BMED-2310-AlphaX/Prototype-Generation-1/alphax_tvns_ble/2x5 cm compact - ORDERED VERSION/render_top.png

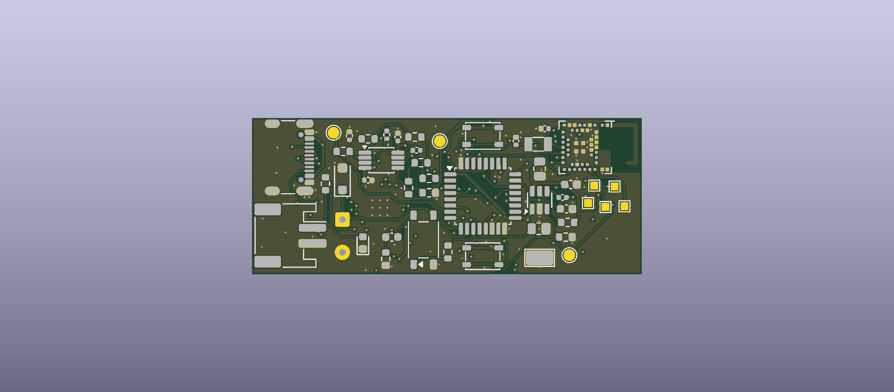
alphax_tvns_ble/2x5 cm compact - ORDERED VERSION/render_top.png
