BMED-2310-AlphaX/Prototype-Generation-1/alphax_tvns_ble/2x5 cm compact/render_bottom.png

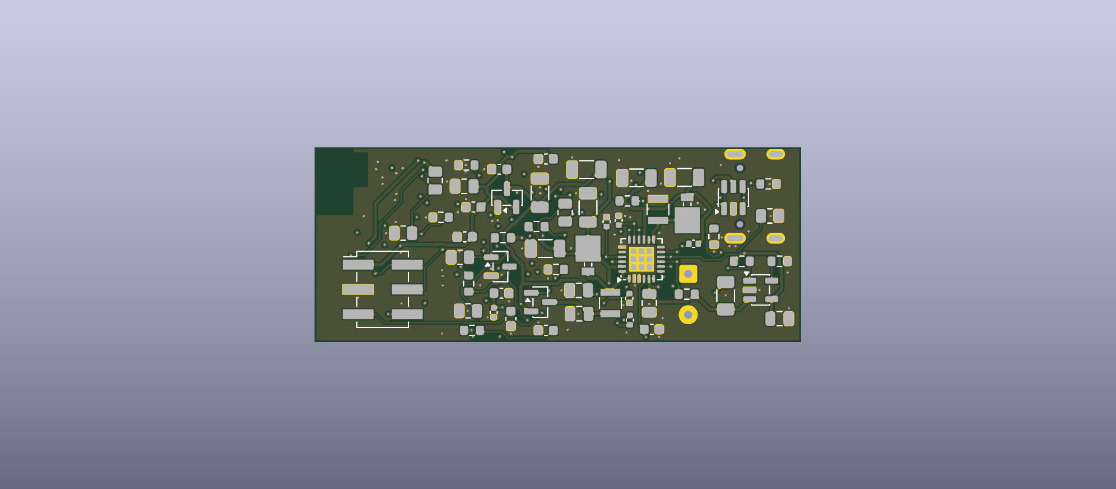
alphax_tvns_ble/2x5 cm compact/render_bottom.png
