BMED-2310-AlphaX/Prototype-Generation-1/alphax_tvns_ble/2x5 cm compact - ORDERED VERSION/DRC_report.txt

** Drc report for STM32G431kbt6_2x5_compact.kicad_pcb **
** Created on 2026-11-11T04:06:39 **
** Report includes: Errors **

** Found 0 DRC violations **

** Found 0 unconnected pads **

** Found 0 Footprint errors **

** Ignored checks **
    - Footprint has no courtyard defined
    - Track endpoint not centered on via
    - Tuning profile track geometries
    - Footprint doesn't match symbol's footprint filters
    - Footprint component type doesn't match footprint pads

** End of Report **
