BMED-2310-AlphaX/Prototype-Generation-1/alphax_tvns_ble/oscilloscope captures/middle rail to C_block output.png

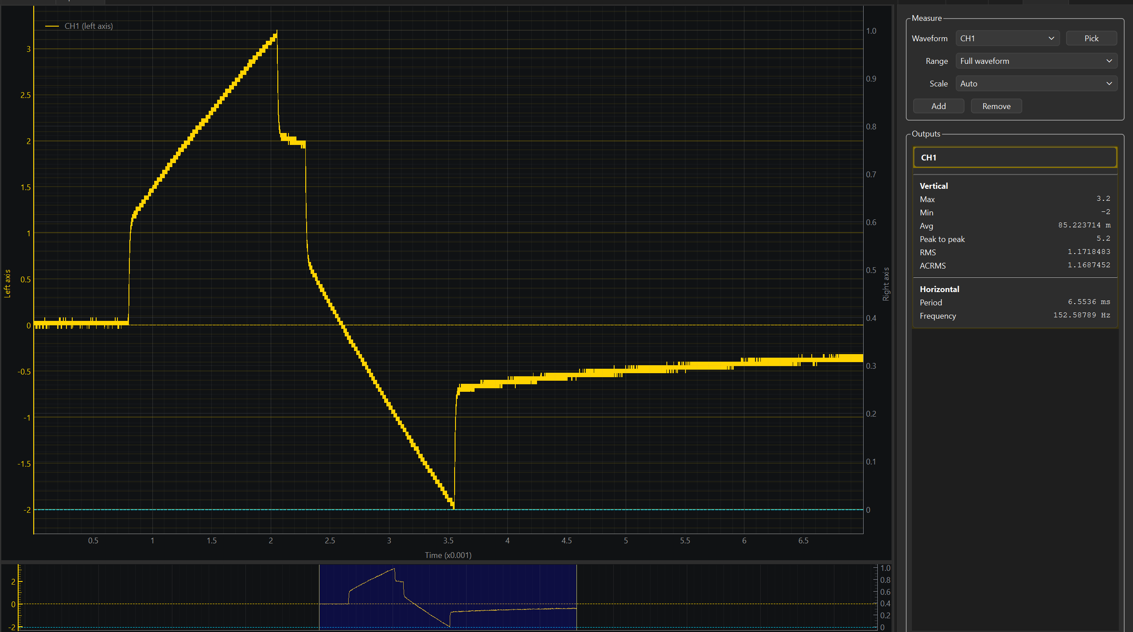
alphax_tvns_ble/oscilloscope captures/middle rail to C_block output.png
