BMED-2310-AlphaX/Prototype-Generation-1/alphax_tvns_ble/oscilloscope captures/TEK_rbody_scaling.png

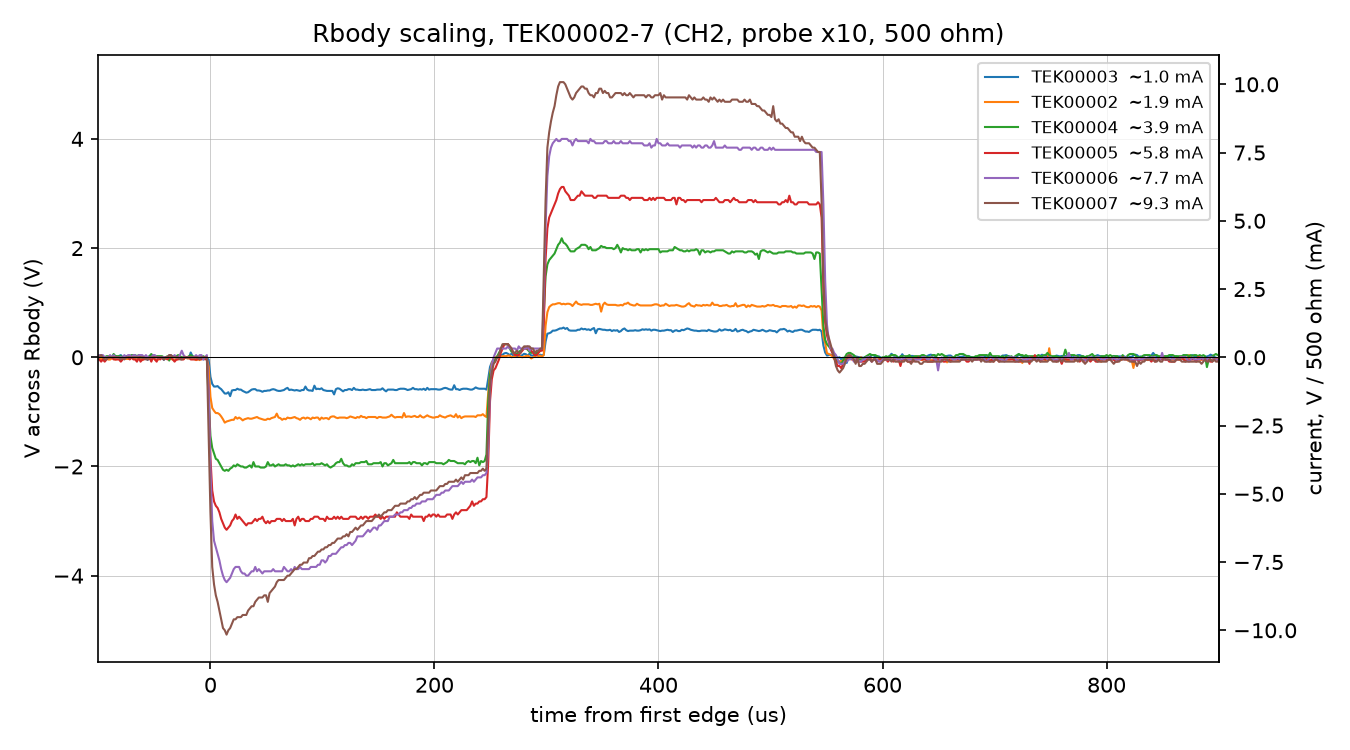
alphax_tvns_ble/oscilloscope captures/TEK_rbody_scaling.png
