BMED-2310-AlphaX/Prototype-Generation-1/alphax_tvns_ble/Screenshot 2026-11-03 141128.png

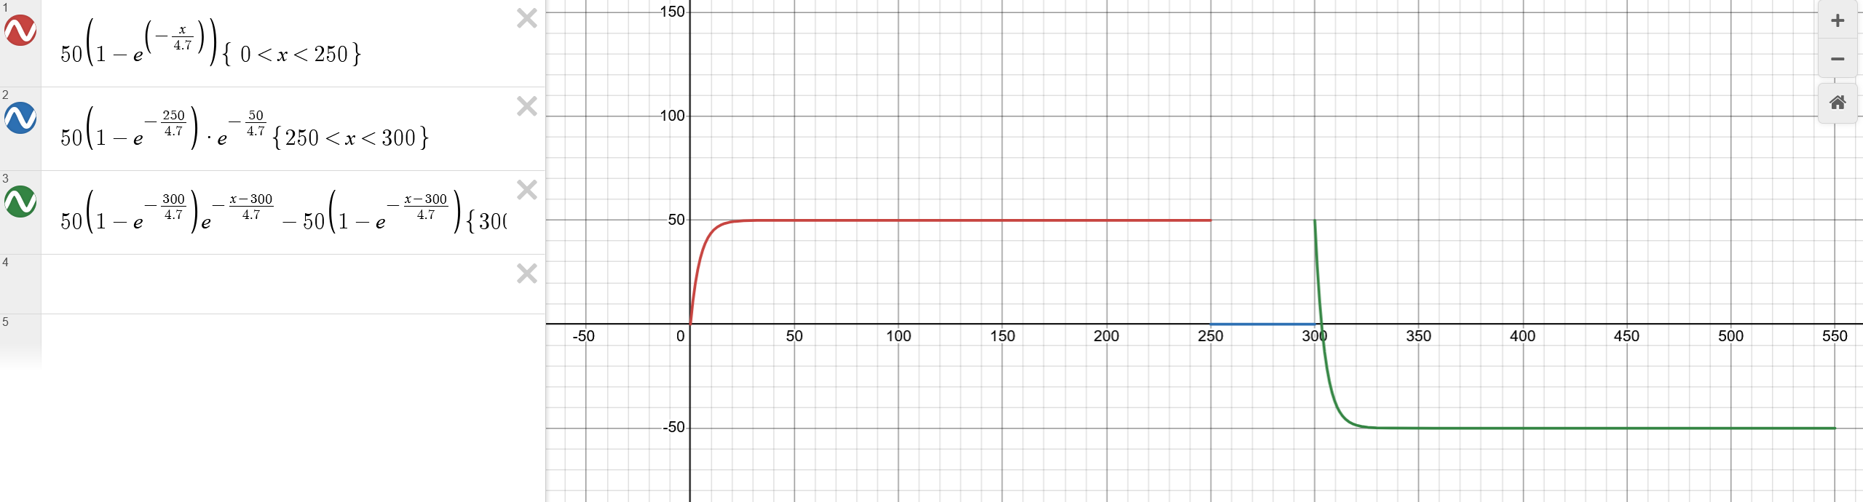
alphax_tvns_ble/Screenshot 2026-11-03 141128.png
