BMED-2310-AlphaX/Prototype-Generation-1/alphax_tvns_ble/2x5 cm compact - ORDERED VERSION/STM32G431kbt6_2x5_compact_colored.step

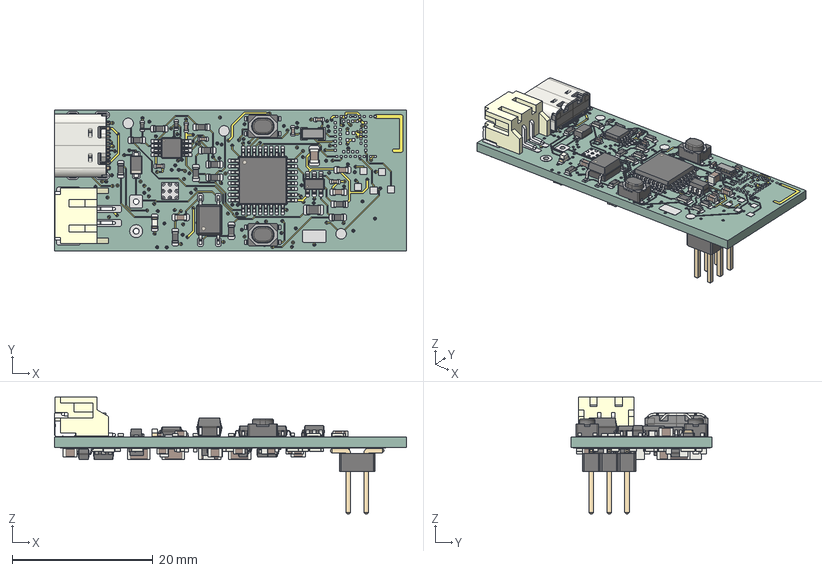
[picture p8: CAD file, 2026-11-11]
alphax_tvns_ble/2x5 cm compact - ORDERED VERSION/STM32G431kbt6_2x5_compact_colored.step
50.0 x 20.0 x 16.6 mm
D_SOD_123F
C_0402_1005Metric_1 x 12
R_0603_1608Metric_1 x 25
C_0603_1608Metric_1 x 11
USB_C_Receptacle_16P_TopMnt_Horizontal_GCT_USB4105-xx-A
Crystal_SMD_3215-2Pin_3.2x1.5mm_1
SOT-23-6_1 x 2
VSSOP-8_3x3mm_P0.65mm_1
R_0402_1005Metric_1 x 2
R_0805_2012Metric_1 x 7
C_0805_2012Metric_1 x 6
SW_SPST_PTS810_1 x 2
LED_0603_1608Metric_1
LQFP-32_7x7mm_P0.8mm_1
Toshiba_SOIC-4-6_4.4x3.6mm_P1.27mm_1
Fuse_1206_3216Metric_1
PinHeader_2x03_P254mm_Vertical_SMD
SOT-23_1 x 3
C_1206_3216Metric_1 x 6
D_Powermite_AK x 2
SOT-23-5_1
STM1C45_copper
STM1C45_pad
STM1C45_via
STM1C45_PCB
S2B-PH-SM4-TB(LF)(SN)
