BMED-2310-AlphaX/Prototype-Generation-1/alphax_tvns_ble/2x5 cm compact/STM32G431kbt6_2x5_compact.step

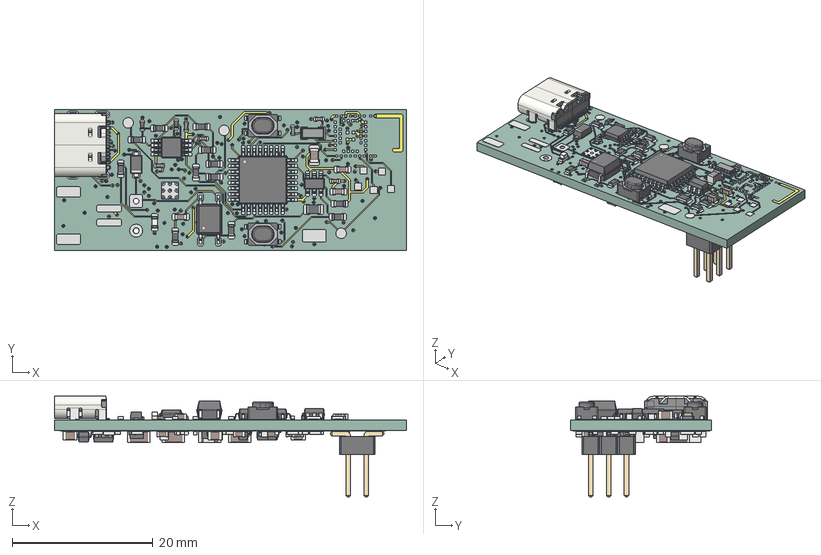
[picture p9: CAD file, 2026-11-11]
alphax_tvns_ble/2x5 cm compact/STM32G431kbt6_2x5_compact.step
50.0 x 20.0 x 14.3 mm
D_SOD_123F
C_0402_1005Metric x 12
R_0603_1608Metric x 25
C_0603_1608Metric x 11
USB_C_Receptacle_16P_TopMnt_Horizontal_GCT_USB4105-xx-A
Crystal_SMD_3215-2Pin_3.2x1.5mm
SOT-23-6 x 2
VSSOP-8_3x3mm_P0.65mm
R_0402_1005Metric x 2
R_0805_2012Metric x 7
C_0805_2012Metric x 6
SW_SPST_PTS810 x 2
LED_0603_1608Metric
LQFP-32_7x7mm_P0.8mm
Toshiba_SOIC-4-6_4.4x3.6mm_P1.27mm
Fuse_1206_3216Metric
PinHeader_2x03_P254mm_Vertical_SMD
SOT-23 x 3
C_1206_3216Metric x 6
D_Powermite_AK x 2
SOT-23-5
STM1C45_copper
STM1C45_pad
STM1C45_via
STM1C45_PCB
