BMED-2310-AlphaX/Prototype-Generation-1/Circuit layout/tvns_stim.asc

Cblock: cap; 2.2µ
Ci: cap; 1µ
Cskin1: cap; {Cskin}
Cskin2: cap; {Cskin}
D1: diode; 1N4148
D2: diode; 1N4148
R1: res; {Rset}
R2: res; {Rset+Rsense}
R3: res; {Rset}
R4: res; {Rset}
Rbleed: res; 100k
Rbody: res; {Rtis}
Ri: res; 1Meg
Rinj2: res; 10Meg
Rinj: res; 10Meg
Rp: res; 1Meg
Rs: res; {Rsense}
Rskin1: res; {Rskin}
Rskin2: res; {Rskin}
U1: UniversalOpAmp2; Avol=100k GBW=10Meg Slew=9Meg; Ilimit=38m Rail=1 Vos=0.5m
U2: UniversalOpAmp2; Avol=100k GBW=10Meg Slew=9Meg; Ilimit=38m Rail=1 Vos=0.5m
V1: voltage; PULSE(0 {Vset} 1m 1u 1u {PW} {1/Freq})
V2: voltage; PULSE(0 {-Vset} {1m+PW+IPG} 1u 1u {PW} {1/Freq})
Vneg: voltage; {-Vrail}
Vpos: voltage; {Vrail}
Named nets: vin, 0, +V, -V, drv, e1, out, inn, inp, sn, sp, vs
Electrode 1 (stim)
Electrode 2 (return) + neck tissue model
Improved Howland current pump (NE5532 half A): Iout = Vin*(1/Rsense + 1/Rset). R2 is trimmed to balance on the bench.
--- Tunable stimulation parameters ---
.param Iamp=2m Freq=25 PW=250u IPG=50u
.param Vrail=9 Rsense=100 Rset=150k
.param Vset={Iamp/(1/Rsense+1/Rset)}
.param Rskin=10k Cskin=470n Rtis=500
.tran 0 {1m+5/Freq} 0 1u
.step param Iamp list 2m 4m 10m 14m
.meas TRAN Ipos MAX I(Rbody)
.meas TRAN Ineg MIN I(Rbody)
.meas TRAN Vmax MAX V(drv)
.meas TRAN Vmin MIN V(drv)
.meas TRAN Qnet INTEG I(Rbody)
DC servo (NE5532 half B): holds the average of V(drv) at 0 V. D1/D2 clamp its inputs so it cannot latch at a rail.
.step param Vrail list 9 18
Vin = GPIO25 - GPIO26 on the bench. Firmware gain calibrated with "gain 29000".
.meas TRAN Voutmax MAX V(out)
.meas TRAN Voutmin MIN V(out)
.meas TRAN I1end FIND I(Rbody) AT={1m+PW-5u}
.meas TRAN Vservo FIND V(vs) AT=1m
