BMED-2310-AlphaX/Prototype-Generation-1/alphax_tvns_ble/wired schematics/STM32G431kbt6_wired.kicad_pcb

## KiCad design alphax_tvns_ble/wired schematics/STM32G431kbt6_wired.kicad_pcb (2026-11-11)

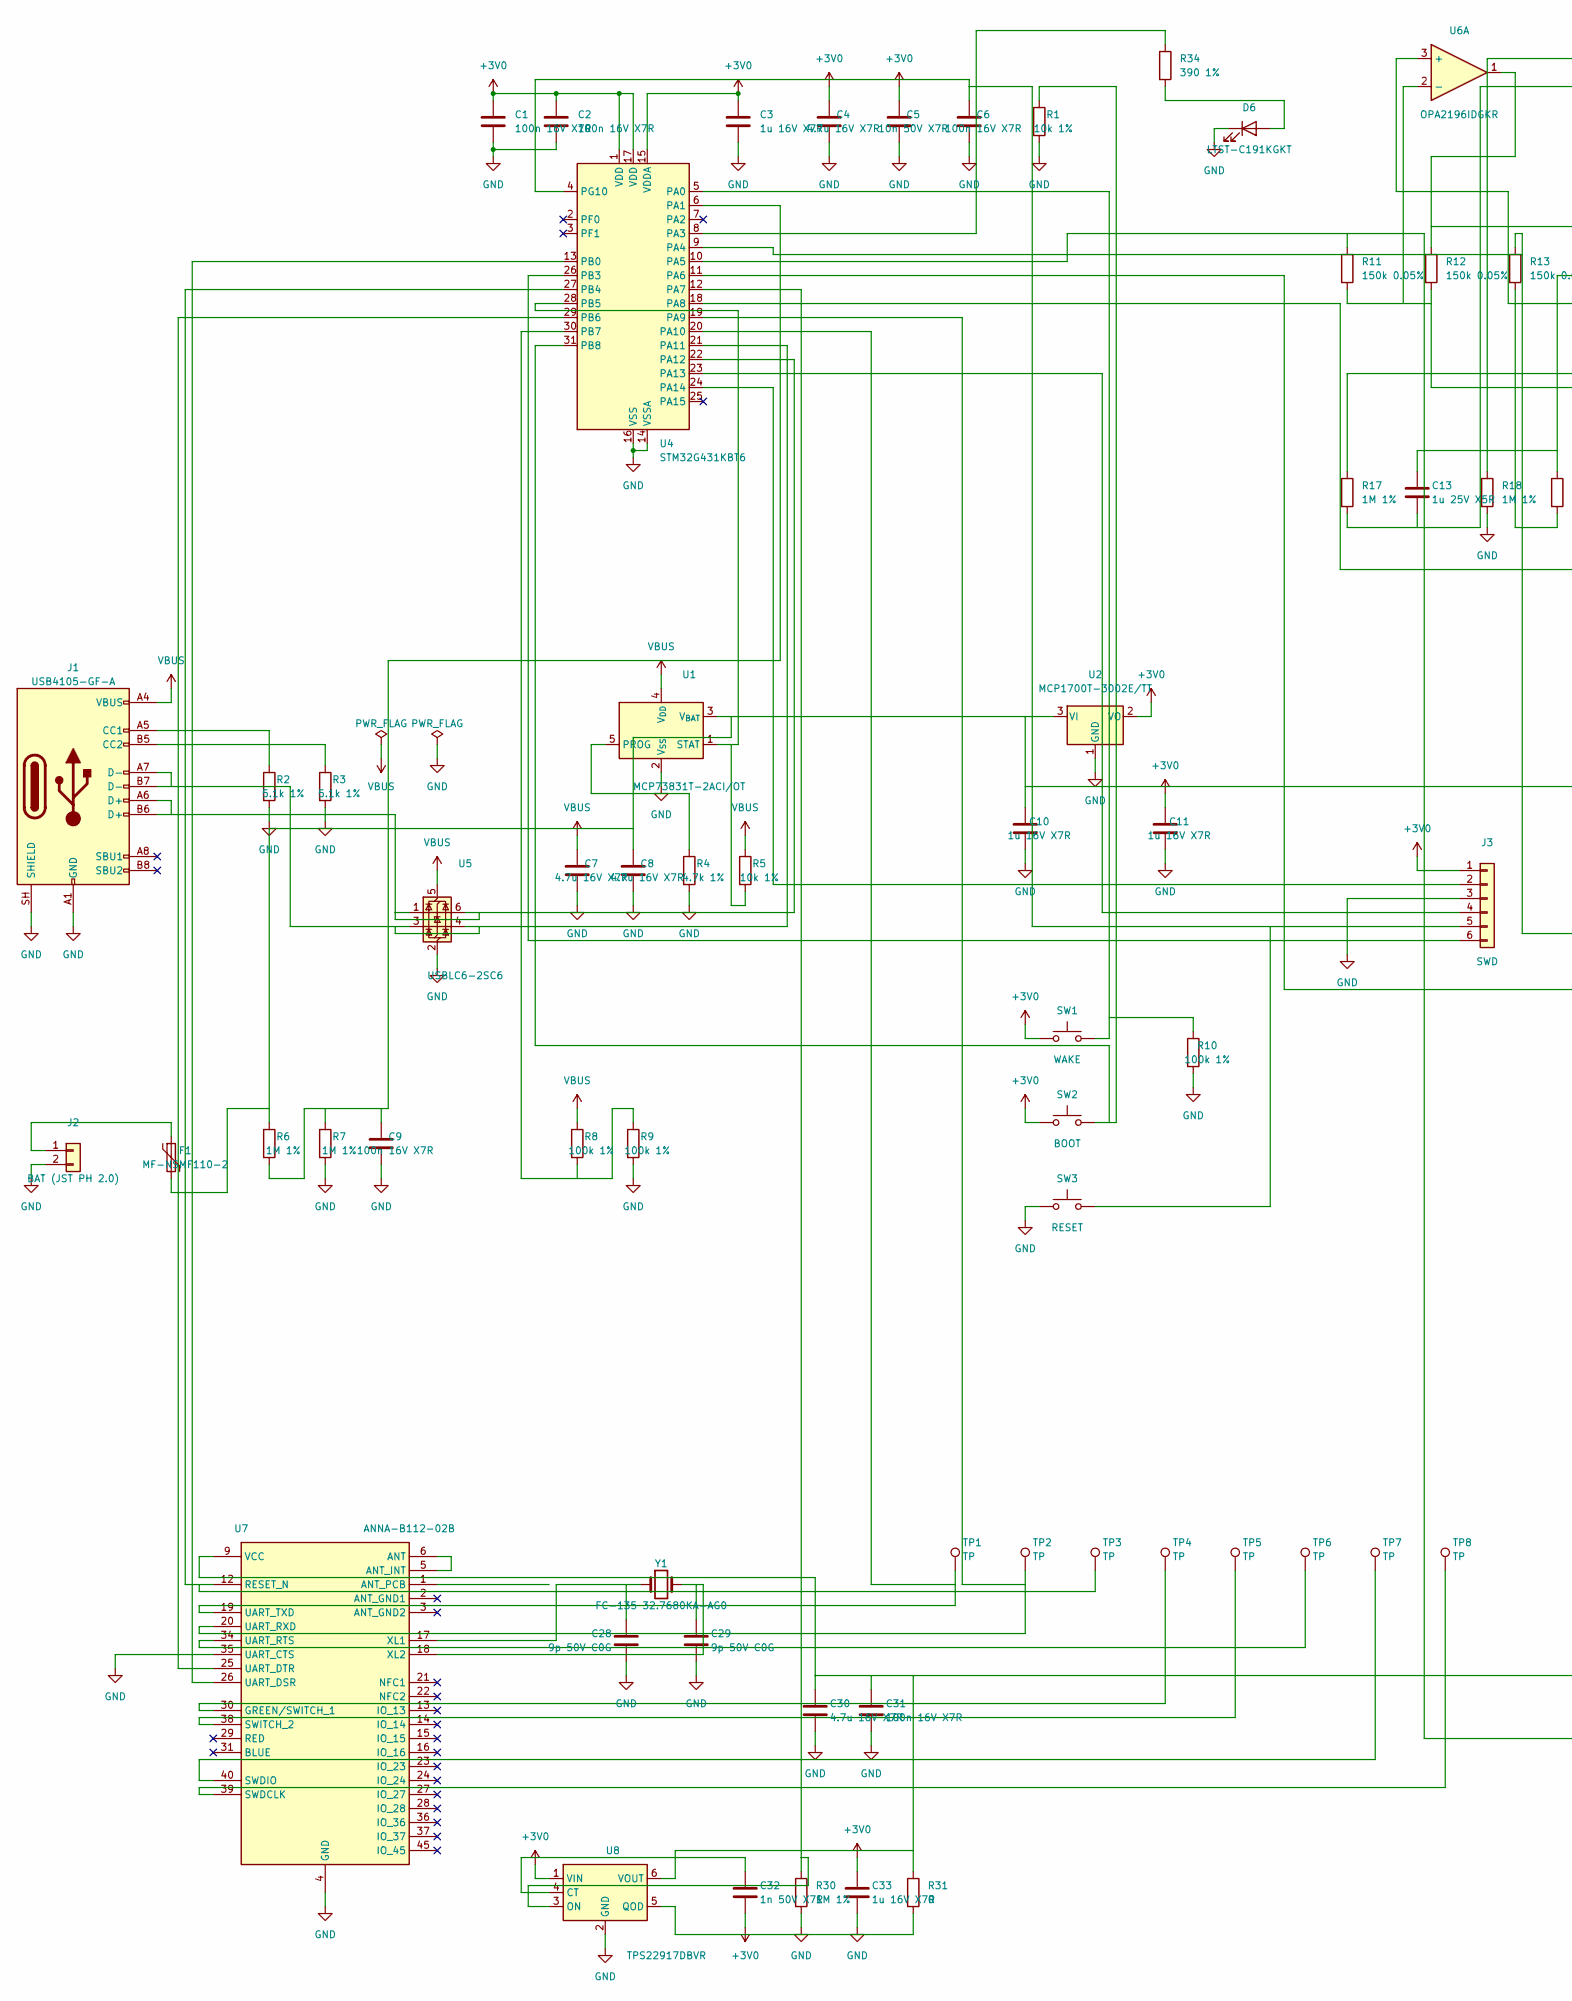
[picture p10: schematic STM32G431kbt6_wired.kicad_sch, part in row 1, column 1]

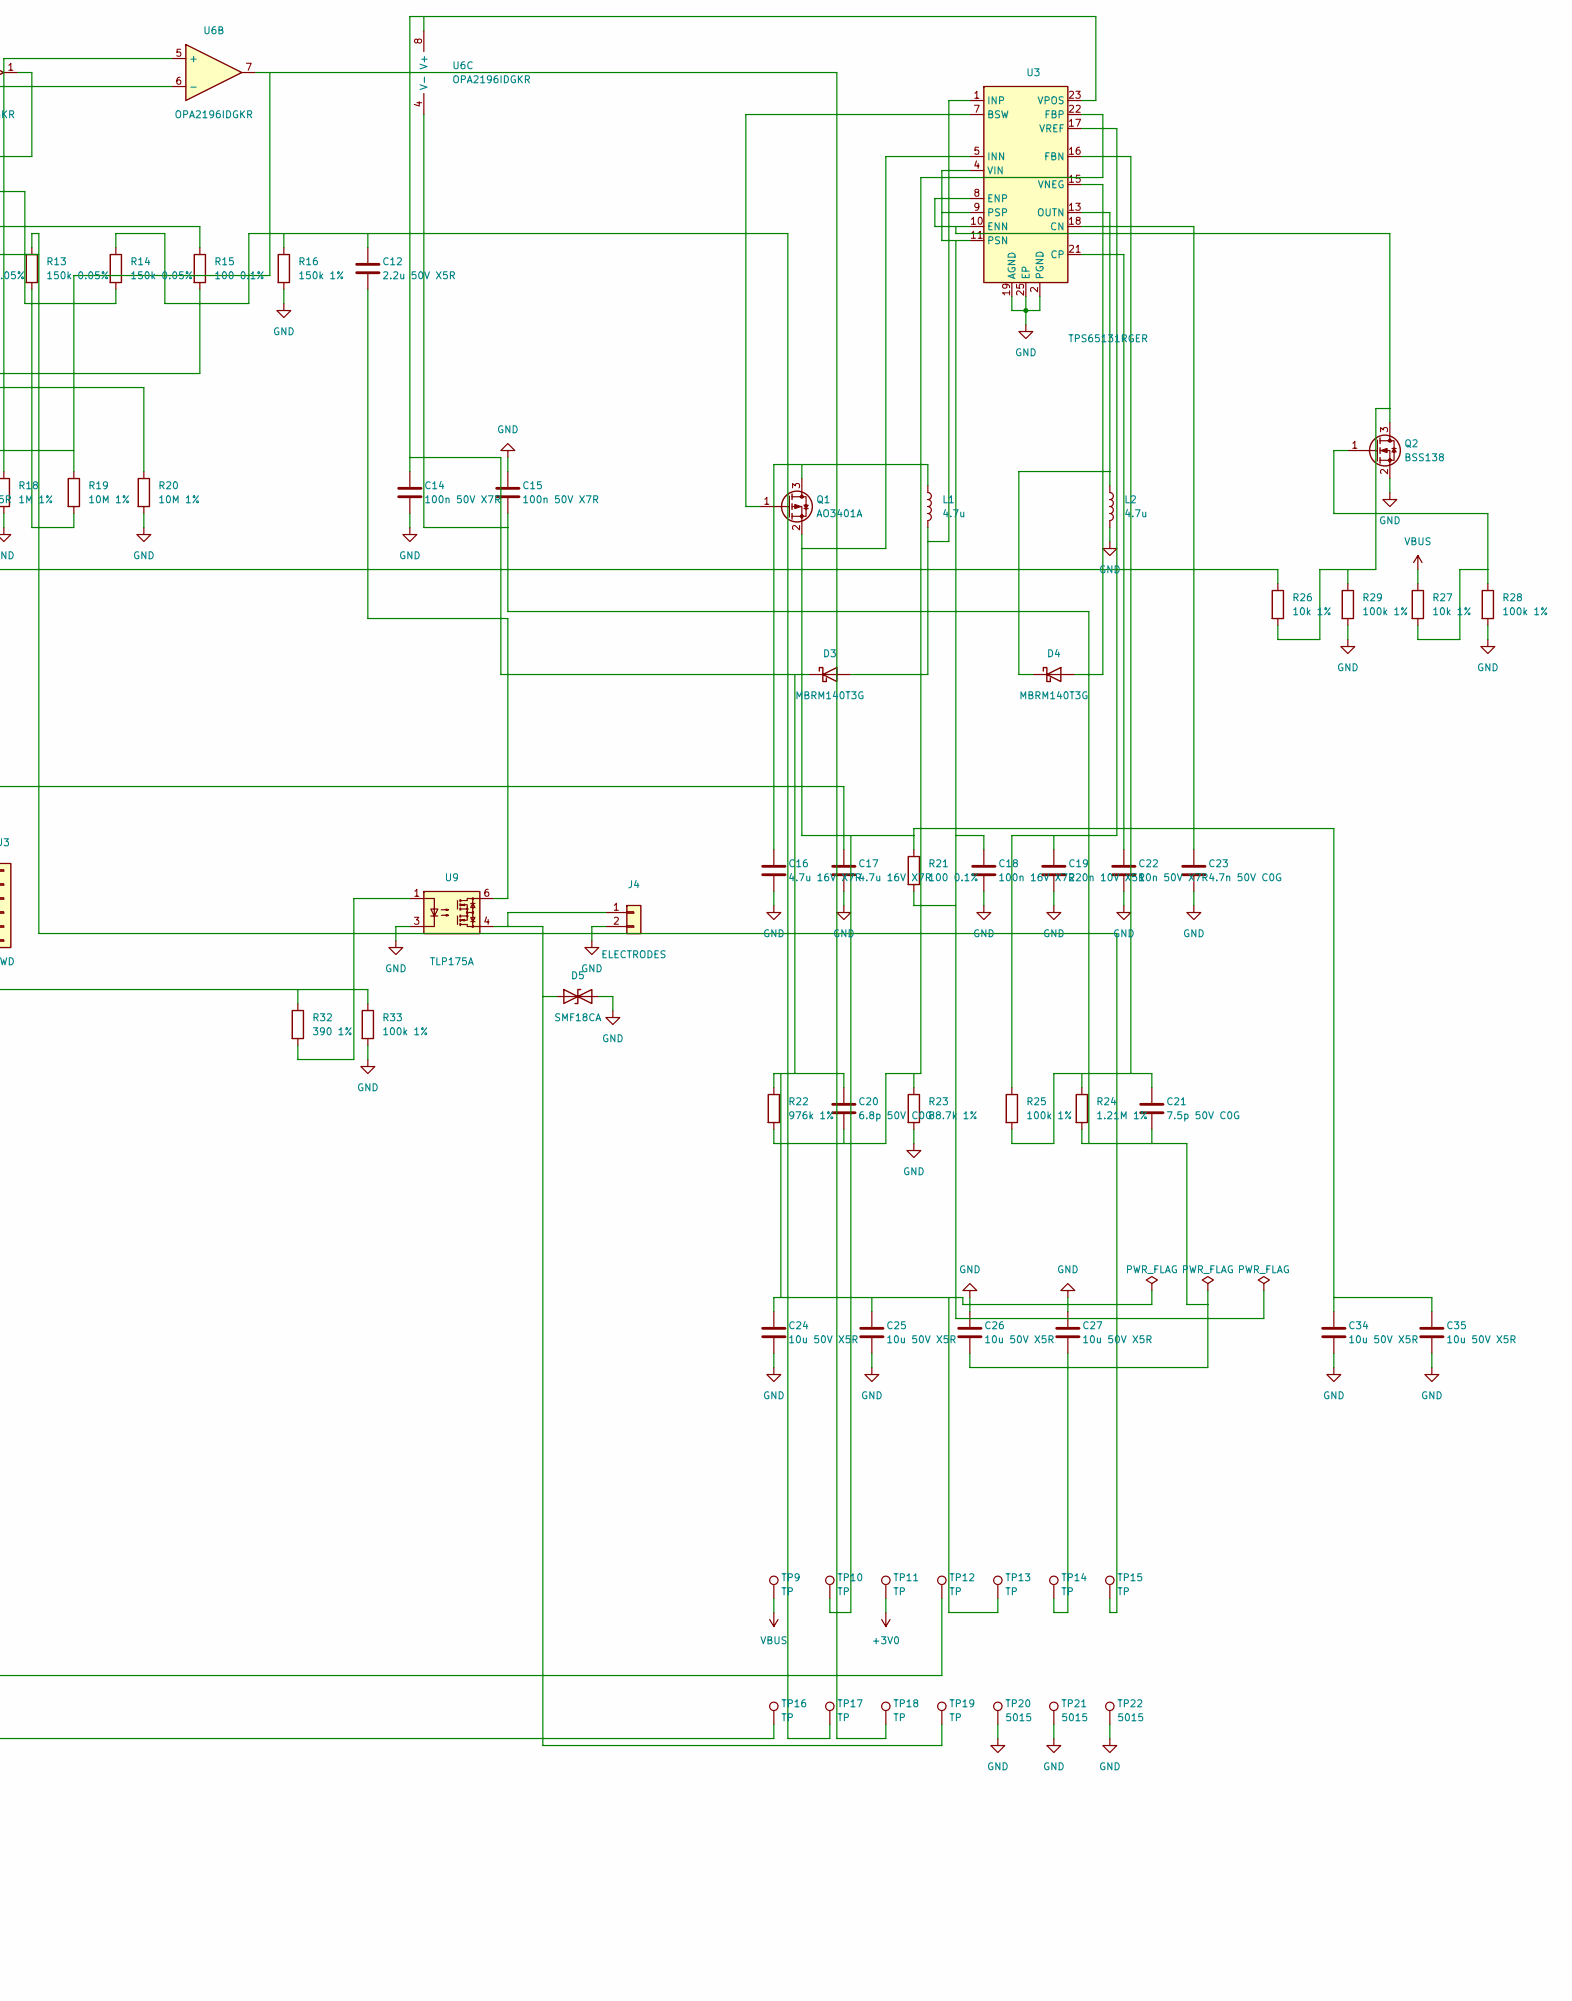
[picture p11: schematic STM32G431kbt6_wired.kicad_sch, part in row 1, column 2]

Parts:
C1, C2, C6, C9, C18, C31: 100n 16V X7R; C_0603_1608Metric; MPN C0603C104M4RACTU
C3, C10, C11, C33: 1u 16V X7R; C_0603_1608Metric; MPN EMK107B7105KA-T
C4, C7, C8, C16, C17, C30: 4.7u 16V X7R; C_0805_2012Metric; MPN GRM21BR71C475KE51L
C5, C22: 10n 50V X7R; C_0402_1005Metric; MPN CL05B103KB5NNNC
C12: 2.2u 50V X5R; C_0603_1608Metric; MPN GRT188R61H225KE13D
C13: 1u 25V X5R; C_0402_1005Metric; MPN C0402B105K025T
C14, C15: 100n 50V X7R; C_0402_1005Metric; MPN GCM155R71H104KE02J
C19: 220n 10V X5R; C_0402_1005Metric; MPN GRM155R61A224KE19D
C20: 6.8p 50V C0G; C_0402_1005Metric; MPN KGM05ACG1H6R8CH
C21: 7.5p 50V C0G; C_0402_1005Metric; MPN CC0402CRNPO9BN7R5
C23: 4.7n 50V C0G; C_0402_1005Metric; MPN GRM1555C1H472JE01D
C24, C25, C26, C27, C34, C35: 10u 50V X5R; C_1206_3216Metric; MPN UMK316BBJ106ML-T
C28, C29: 9p 50V C0G; C_0402_1005Metric; MPN CC0402CRNPO9BN9R0
C32: 1n 50V X7R; C_0402_1005Metric; MPN C0402C102K5RACTU
D3, D4: MBRM140T3G; D_Powermite_LargeCathode; MPN MBRM140T3G; DigiKey MBRM140T3GOSCT-ND
D5: SMF18CA; D_SOD-123F; MPN SMF18CA
D6: LTST-C191KGKT; LED_0603_1608Metric; MPN LTST-C191KGKT; DigiKey 160-1446-1-ND
F1: MF-NSMF110-2; Fuse_1206_3216Metric; MPN MF-NSMF110-2
J1: USB4105-GF-A; USB_C_Receptacle_GCT_USB4105-xx-A_16P_TopMnt_Horizontal; MPN USB4105-GF-A
J2: BAT (JST PH 2.0); JST_PH_S2B-PH-SM4-TB_1x02-1MP_P2.00mm_Horizontal; MPN S2B-PH-SM4-TB(LF)(SN)
J3: SWD; PinHeader_2x03_P2.54mm_Vertical_SMD; MPN PHED-SS006G1ABONE-B300
J4: ELECTRODES; SolderWire-0.25sqmm_1x02_P4.2mm_D0.65mm_OD1.7mm_Relief
L1, L2: 4.7u; L_TDK_TFM252012; MPN TFM252012ALMA4R7MTAA
Q1: AO3401A; SOT-23; MPN AO3401A
Q2: BSS138; SOT-23; MPN BSS138; DigiKey BSS138CT-ND
R1, R5, R26, R27: 10k 1%; R_0603_1608Metric; MPN RNCP0603FTD10K0
R2, R3: 5.1k 1%; R_0603_1608Metric; MPN RT0603FRE075K1L
R4: 4.7k 1%; R_0603_1608Metric; MPN RT0603FRE074K7L
R6, R7, R17, R18, R30: 1M 1%; R_0603_1608Metric; MPN MCT06030C1004FPW00
R8, R9, R10, R25, R28, R29, R33: 100k 1%; R_0805_2012Metric; MPN RT0805FRD07100KL
R11, R12, R13, R14: 150k 0.05%; R_0603_1608Metric; MPN RG1608N-154-W-T1; DigiKey RG16N150KWCT-ND
R15, R21: 100 0.1%; R_0603_1608Metric; MPN RG1608P-101-B-T5; DigiKey RG16P100BCT-ND
R16: 150k 1%; R_0603_1608Metric; MPN ERJ-3EKF1503V
R19, R20: 10M 1%; R_0402_1005Metric; MPN RMCF0402FT10M0
R22: 976k 1%; R_0603_1608Metric; MPN CR0603-FX-9763ELF
R23: 88.7k 1%; R_0603_1608Metric; MPN CR0603-FX-8872ELF
R24: 1.21M 1%; R_0603_1608Metric; MPN RM06F1214CT
R31: 0; R_0603_1608Metric; MPN MCT0603MZ0000ZP500
R32, R34: 390 1%; R_0603_1608Metric; MPN RT0603FRE07390RL
SW1: WAKE; SW_SPST_PTS810; MPN PTS810 SJM 250 SMTR LFS
SW2: BOOT; SW_SPST_PTS810; MPN PTS810 SJM 250 SMTR LFS
SW3: RESET; SW_SPST_PTS810; MPN PTS810 SJM 250 SMTR LFS
TP1, TP2, TP3, TP4, TP5, TP6, TP7, TP8: TP; TestPoint_Pad_1.0x1.0mm
TP9, TP10, TP11, TP12, TP13, TP14, TP15, TP16, TP17, TP18, TP19: TP; TestPoint_Pad_D1.5mm
TP20, TP21, TP22: 5015; TestPoint_Keystone_5015_Micro_Mini; MPN 5015
U1: MCP73831T-2ACI/OT; SOT-23-5; MPN MCP73831T-2ACI/OT
U2: MCP1700T-3002E/TT; SOT-23; MPN MCP1700T-3002E/TT
U3: TPS65131RGER; VQFN-24-1EP_4x4mm_P0.5mm_EP2.45x2.45mm_ThermalVias; MPN TPS65131RGER
U4: STM32G431KBT6; LQFP-32_7x7mm_P0.8mm; MPN STM32G431KBT6
U5: USBLC6-2SC6; SOT-23-6; MPN USBLC6-2SC6
U6: OPA2196IDGKR; VSSOP-8_3x3mm_P0.65mm; MPN OPA2196IDGKR
U7: ANNA-B112-02B; u-blox_ANNA-B112; MPN ANNA-B112-02B
U8: TPS22917DBVR; SOT-23-6; MPN TPS22917DBVR
U9: TLP175A; Toshiba_SOIC-4-6_4.4x3.6mm_P1.27mm; MPN TLP175A(TPL,E
Y1: FC-135 32.7680KA-AG0; Crystal_SMD_3215-2Pin_3.2x1.5mm; MPN FC-135 32.7680KA-AG0; DigiKey 114-FC-13532.7680KA-AG0CT-ND

Connections:
+3V0: C1.1, C2.1, C3.1, C4.1, C5.1, C11.1, C32.2, C33.1, J3.1, SW1.1, SW2.1, TP11.1 (1_1), U2.2 (VO), U4.1 (VDD), U4.15 (VDDA), U4.17 (VDD), U8.1 (VIN)
GND: C1.2, C2.2, C3.2, C4.2, C5.2, C6.2, C7.2, C8.2, C9.2, C10.2, C11.2, C14.2, C15.1, C16.2, C17.2, C18.2, C19.2, C22.2, C23.2, C24.2, C25.2, C26.1, C27.1, C28.2, C29.2, C30.2, C31.2, C33.2, C34.2, C35.2, D5.2 (A2), D6.1 (K), J1.A1 (GND), J1.A12 (GND), J1.B1 (GND), J1.B12 (GND), J1.SH (SHIELD), J2.2, J3.3, J4.2, L2.2, Q2.2 (S), R1.2, R2.2, R3.2, R4.2, R7.2, R9.2, R10.2, R16.2, R18.2, R20.2, R23.2, R28.2, R29.2, R30.2, R33.2, SW3.1 (1_1), TP20.1 (1_1), TP21.1 (1_1), TP22.1 (1_1), U1.2 (V_{SS}), U2.1 (GND), U3.2 (PGND), U3.3 (PGND), U3.19 (AGND), U3.25 (EP), U4.14 (VSSA), U4.16 (VSS), U4.32 (VSS), U5.2 (GND), U7.4 (GND), U7.7 (GND), U7.8 (GND), U7.10 (GND), U7.11 (GND), U7.32 (GND), U7.33 (GND), U7.35 (UART_CTS), U7.41 (GND), U7.42 (GND), U7.43 (GND), U7.44 (GND), U7.46 (GND), U7.47 (GND), U7.48 (GND), U7.49 (GND), U7.50 (GND), U7.51 (GND), U7.52 (GND), U8.2 (GND), U9.3; also elsewhere on the board
unnamed: C12.1, R14.1, R15.2, R16.1, R17.1, TP17.1 (1_1)
unnamed: C12.2, U9.6
unnamed: C20.1, R22.1
unnamed: C21.1, R24.1, R25.2
unnamed: C21.2, C26.2, C27.2, R24.2, TP14.1 (1_1)
unnamed: C24.1, C25.1
unnamed: D3.2 (A), L1.2, U3.1 (INP), U3.24 (INP)
unnamed: C14.1, D3.1 (K), U3.23 (VPOS), U6.8 (V+)
unnamed: C15.2, D4.2 (A), U3.15 (VNEG), U6.4 (V-)
unnamed: D4.1 (K), L2.1, U3.13 (OUTN), U3.14 (OUTN)
unnamed: D5.1 (A1), J4.1, TP19.1 (1_1), U9.4
unnamed: D6.2 (A), R34.2
unnamed: F1.2, R6.1
unnamed: J1.A5 (CC1), R2.1
unnamed: J1.B5 (CC2), R3.1
unnamed: F1.1, J2.1
unnamed: J3.2, U4.24 (PA14)
unnamed: J3.4, U4.23 (PA13)
unnamed: C6.1, J3.5, U4.4 (PG10)
unnamed: J3.6, U4.26 (PB3)
unnamed: C16.1, L1.1, Q1.3 (D)
unnamed: Q1.1 (G), U3.7 (BSW)
unnamed: C17.1, C34.1, C35.1, Q1.2 (S), R21.1, U3.5 (INN), U3.6 (INN)
unnamed: Q2.3 (D), R26.2, R29.1, U3.8 (ENP), U3.10 (ENN)
unnamed: Q2.1 (G), R27.2, R28.1
unnamed: R11.2, R12.2, R20.1
unnamed: R12.1, U6.1
unnamed: R13.1, TP15.1 (1_1)
unnamed: R19.1, TP18.1 (1_1), U6.7
unnamed: R32.2, U9.1
unnamed: R4.1, U1.5 (PROG)
unnamed: R5.2, U1.1 (STAT), U4.28 (PB5)
unnamed: C8.1, U1.3 (V_{BAT}), U2.3 (VI)
unnamed: C23.1, U3.18 (CN)
unnamed: C22.1, U3.21 (CP)
unnamed: C20.2, R22.2, R23.1, U3.22 (FBP)
unnamed: U3.4 (VIN), U3.9 (PSP), U3.11 (PSN)
unnamed: C19.1, R25.1, U3.17 (VREF)
unnamed: SW1.2, U4.5 (PA0)
unnamed: C9.1, R6.2, R7.1, U4.6 (PA1)
unnamed: R34.1, U4.8 (PA3)
unnamed: R11.1, TP16.1 (1_1), U4.10 (PA5)
unnamed: R32.1, R33.1, U4.11 (PA6)
unnamed: R30.1, U4.12 (PA7), U8.3 (ON)
unnamed: R26.1, U4.18 (PA8)
unnamed: TP2.1 (1_1), U4.19 (PA9), U7.20 (UART_RXD)
unnamed: TP1.1 (1_1), U4.20 (PA10), U7.19 (UART_TXD)
unnamed: J1.A7 (D-), J1.B7 (D-), U4.21 (PA11), U5.3 (I/O2), U5.4 (I/O2)
unnamed: J1.A6 (D+), J1.B6 (D+), U4.22 (PA12), U5.1 (I/O1), U5.6 (I/O1)
unnamed: U4.13 (PB0), U7.26 (UART_DSR)
unnamed: TP3.1 (1_1), U4.27 (PB4), U7.12 (RESET_N)
unnamed: U4.29 (PB6), U7.25 (UART_DTR)
unnamed: R8.2, R9.1, U4.30 (PB7)
unnamed: R1.1, SW2.2, U4.31 (PB8)
unnamed: R13.2, R14.2, R19.2, U6.3 (+)
unnamed: R18.1, U6.5 (+)
unnamed: C13.2, R17.2, U6.6 (-)
unnamed: U7.5 (ANT_INT), U7.6 (ANT)
unnamed: TP4.1 (1_1), U7.30 (GREEN/SWITCH_1)
unnamed: TP8.1 (1_1), U7.39 (SWDCLK)
unnamed: TP7.1 (1_1), U7.40 (SWDIO)
unnamed: TP5.1 (1_1), U7.38 (SWITCH_2)
unnamed: TP6.1 (1_1), U7.34 (UART_RTS)
unnamed: C30.1, C31.1, TP12.1 (1_1), U7.9 (VCC)
unnamed: C28.1, U7.17 (XL1), Y1.1
unnamed: C29.1, U7.18 (XL2), Y1.2
unnamed: C32.1, U8.4 (CT)
unnamed: R31.2, U8.5 (QOD)
VBUS: C7.1, J1.A4 (VBUS), J1.A9 (VBUS), J1.B4 (VBUS), J1.B9 (VBUS), R5.1, R8.1, R27.1, TP9.1 (1_1), U1.4 (V_{DD}), U5.5 (VBUS)

Board: 4 copper layers, 118 parts (0 on the bottom side), 71 nets, no tracks yet.

Other parts of the board:
NT1: NetTie_2; NetTie-2_SMD_Pad0.5mm

Their connections:
GND: NT1.2; also elsewhere on the board
