BMED-2310-AlphaX/Prototype-Generation-1/alphax_tvns_ble/STM32G431kbt6/Core/Inc/main.h

#define WAKE_Pin GPIO_PIN_0
#define WAKE_GPIO_Port GPIOA
#define WAKE_EXTI_IRQn EXTI0_IRQn
#define VBAT_SENSE_Pin GPIO_PIN_1
#define VBAT_SENSE_GPIO_Port GPIOA
#define STATUS_LED_Pin GPIO_PIN_3
#define STATUS_LED_GPIO_Port GPIOA
#define DAC_STIM_Pin GPIO_PIN_4
#define DAC_STIM_GPIO_Port GPIOA
#define DAC_REF_Pin GPIO_PIN_5
#define DAC_REF_GPIO_Port GPIOA
#define OUT_EN_Pin GPIO_PIN_6
#define OUT_EN_GPIO_Port GPIOA
#define BLE_EN_Pin GPIO_PIN_7
#define BLE_EN_GPIO_Port GPIOA
#define BLE_DSR_Pin GPIO_PIN_0
#define BLE_DSR_GPIO_Port GPIOB
#define EN_RAIL_MCU_Pin GPIO_PIN_8
#define EN_RAIL_MCU_GPIO_Port GPIOA
#define BLE_RXD_Pin GPIO_PIN_9
#define BLE_RXD_GPIO_Port GPIOA
#define BLE_TXD_Pin GPIO_PIN_10
#define BLE_TXD_GPIO_Port GPIOA
#define USB_DM_Pin GPIO_PIN_11
#define USB_DM_GPIO_Port GPIOA
#define USB_DP_Pin GPIO_PIN_12
#define USB_DP_GPIO_Port GPIOA
#define SWDIO_Pin GPIO_PIN_13
#define SWDIO_GPIO_Port GPIOA
#define SWCLK_Pin GPIO_PIN_14
#define SWCLK_GPIO_Port GPIOA
#define SWO_Pin GPIO_PIN_3
#define SWO_GPIO_Port GPIOB
#define BLE_RESET_N_Pin GPIO_PIN_4
#define BLE_RESET_N_GPIO_Port GPIOB
#define STAT_Pin GPIO_PIN_5
#define STAT_GPIO_Port GPIOB
#define BLE_DTR_Pin GPIO_PIN_6
#define BLE_DTR_GPIO_Port GPIOB
#define VBUS_SENSE_Pin GPIO_PIN_7
#define VBUS_SENSE_GPIO_Port GPIOB
#define VBUS_SENSE_EXTI_IRQn EXTI9_5_IRQn
