BMED-2310-AlphaX/Prototype-Generation-1/(commit log)

2026-10-27 Add circuit layout, ESP32 draft stim, STM32 stim
2026-10-29 adding app/esp32 code
    blah
2026-11-05 Add oscilloscope test files for CES and prototype.
2026-11-06 New analyses of the updated DC servo additions to the stimulating circuit
2026-11-08 added KiCad files for stm32g431kbt6. reorganized oscilloscope files
2026-11-08 Added battery management, USB programming functionality, and bootloading
2026-11-10 Added parts list for full chip parts and validated circuits.
2026-11-10 Fixed BOM issues.
2026-11-10 New manual schematics.
2026-11-11 Zipped gerber files for PCB ordering
2026-11-11 Added STEP file for the colored PCB, including SMD and connectors.
