BMED-2310-AlphaX/Prototype-Generation-1/(notices)

Notices in the files:
alphax_tvns_ble/STM32G431kbt6/Core/Inc/main.h:
Copyright (c) 2026 STMicroelectronics.
All rights reserved.
This software is licensed under terms that can be found in the LICENSE file
